torst3n/lwz180-home-assistant/(commit log)

2026-05-23 Initial commit of robust LWZ180 HA integration with 14 sensors
2026-08-14 fix(bridge): detect level 0 when display digit is off and add wifi reconnect fallback
    [esp32-lwz180-ha.ino, lwz180-bridge.ino]
2026-09-28 fix(control): resolve timing underflow, Standby wake-up, and Level 3 boost control
    - Fix 4 ms timeout caused by unsigned integer underflow when millis() wrapped
    - Prevent false Level 0 detection by positively confirming Standby status
    - Add 8-pulse wake-up burst for 0 -> 1 transitions to wake capacitive touch wheel
    - Add direct motherboard fan stage telemetry register parsing (0x02, 0x05, 0x69, 0x6d)
    - Add Level 3 support in Home Assistant discovery, MQTT, and USB CLI with automatic Power Vent mapping
    - Add interactive USB Serial CLI to ESP32 for direct debugging and diagnostics
    - Set MQTT keepalive to 30s for connection stability
    [esp32-lwz180-ha.ino, lwz180-bridge.ino]
2026-09-28 feat(esp32): add remote debugging via Web Dashboard, Telnet, ArduinoOTA, and MQTT watchdog
2026-09-28 feat(debug): add remote diagnostics, I2C bus sniffing, and bridge reset capabilities
    [esp32-lwz180-ha.ino, lwz180-bridge.ino]
2026-09-28 docs: add perfboard assembly guide and pin-to-pin soldering plan
2026-09-28 feat(hardware): add custom PCB design, Gerber manufacturing files, BOM, and renders
    [BOM.csv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]
2026-09-28 feat(pcb): add AISLER-optimized ZIP package
2026-09-28 fix(pcb): fix board outline to single continuous closed contour for AISLER
    [lwz180_bridge.kicad_pcb]
